mp-se/stirplate/cad/Stirplate.pdf

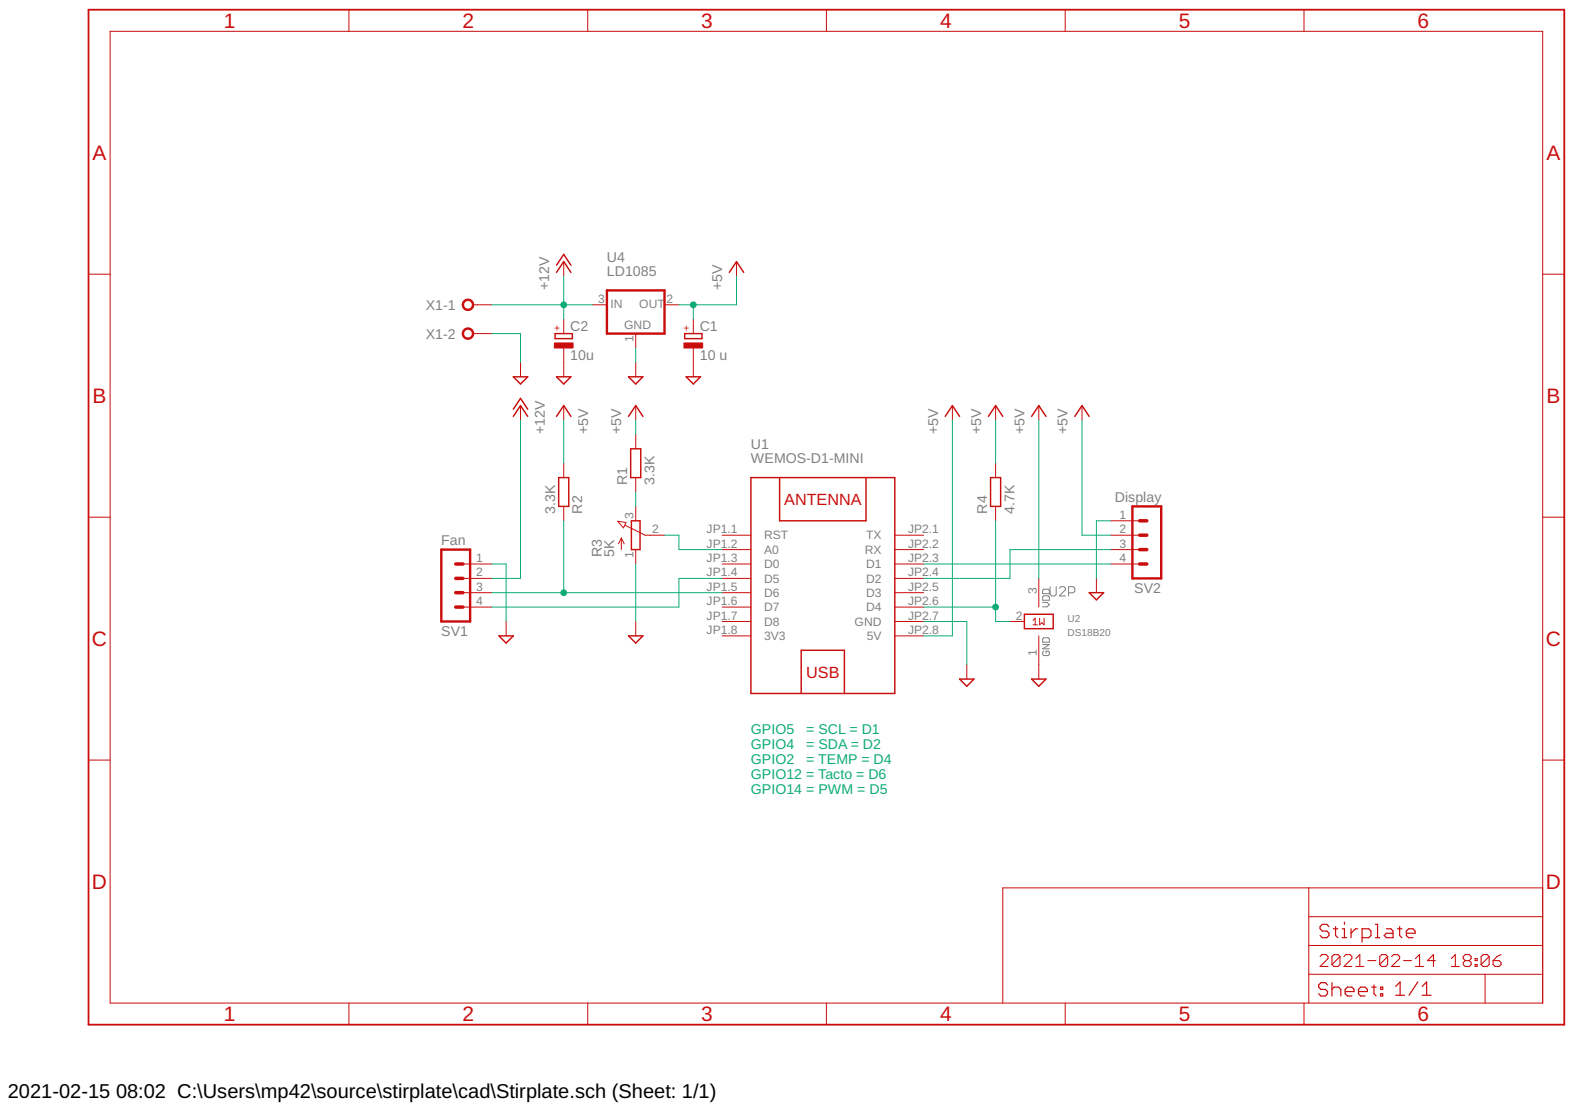
[picture p8: page 1]

JP2.5 D4
JP2.6 GND JP2.7

2021-02-15 08:02 C:\Users\mp42\source\stirplate\cad\Stirplate.sch (Sheet: 1/1)
