mp-se/stirplate/src/main.cpp

/*
MIT License

Copyright (c) 2021 Magnus

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
THE SOFTWARE IS PROVIDED "AS IS", WITHOUT WARRANTY OF ANY KIND, EXPRESS OR
IMPLIED, INCLUDING BUT NOT LIMITED TO THE WARRANTIES OF MERCHANTABILITY,
FITNESS FOR A PARTICULAR PURPOSE AND NONINFRINGEMENT. IN NO EVENT SHALL THE
AUTHORS OR COPYRIGHT HOLDERS BE LIABLE FOR ANY CLAIM, DAMAGES OR OTHER
LIABILITY, WHETHER IN AN ACTION OF CONTRACT, TORT OR OTHERWISE, ARISING FROM,
OUT OF OR IN CONNECTION WITH THE SOFTWARE OR THE USE OR OTHER DEALINGS IN THE
SOFTWARE.
 */
#include "helper.h"
#include "display.h"
#include "pwmfan.h"
#include "config.h"
#include "blynk.h"
#include "pushtarget.h"
#include "analogsensor.h"
#include "tempsensor.h"
#include "wifi.h"

// Settings for double reset
#define ESP8266_DRD_USE_RTC       true
#define DRD_TIMEOUT               1
#define DRD_ADDRESS               0
#define DOUBLERESETDETECTOR_DEBUG true
#include <ESP_DoubleResetDetector.h>            
DoubleResetDetector *drd;

/*
 * This is the fan I used for my build.
 * https://noctua.at/pub/media/wysiwyg/Noctua_PWM_specifications_white_paper.pdf
 * Blue = PWM
 * Green = RPM 
 * Yellow = 12V
 * Black = GND
 * 
 * PWM Frequency: Target frequency 25 kHz, 
 * acceptable operational range 21 kHz to 28 kHz 
 * Maximum voltage for logic low: VIL = 0.8 V 
 * Absolute maximum current sourced: Imax = 5 mA (short circuit current)  
 * Absolute maximum voltage level: VMax = 5.25 V (open circuit voltage) 
 * This signal must be pulled up to a maximum of 5.25V within the fan.
 */

// Define constats for this program
#define LOOP_INTERVAL 100                // ms, time to wait between running the loop code
const static int     tachPIN = 12;       // Measure speed on FAN. D6 PIN on ESP-12F

//
// Callback for tachimeter
// 
void ICACHE_RAM_ATTR handleTachiometerInterrupt() {
    myFan.tachCallback();
}

//
// Main setup 
//
void setup() {

    // Initialize pin outputs
    Log.notice(F("Main: Started setup for %s." CR), String( ESP.getChipId(), HEX).c_str() );
    printBuildOptions();
    drd = new DoubleResetDetector(DRD_TIMEOUT, DRD_ADDRESS);
    bool dt = drd->detectDoubleReset();  

    Log.notice(F("Main: Loading configuration." CR));
    myConfig.checkFileSystem();
    myConfig.loadFile();

    Log.notice(F("Main: Setting up devices." CR));

#if LOG_LEVEL==6
//  Log.verbose(F("MAIN: Wait 5s for debugger to come online." CR));
//  delay(5000);
#endif

    // Setup watchdog
    ESP.wdtDisable();
    ESP.wdtEnable( LOOP_INTERVAL * 2 );

    // Setup display
    Log.notice(F("Main: Looking for display." CR));
    myDisplay.init();

    char buffer[20];
    sprintf( &buffer[0], "%s", CFG_APPNAME );
    myDisplay.printText( 0, 0, &buffer[0] );    

#if defined( ACTIVATE_WIFI )
    if( dt ) 
        Log.notice(F("Main: Detected doubletap on reset." CR));

    myDisplay.printText( 0, 1, "Connect wifi    " );    
    myWifi.connect( dt );
    if( myWifi.isConnected() )
        Log.notice(F("Main: Connected to wifi ip=%s." CR), myWifi.getIPAddress().c_str() );
#endif

#if defined( ACTIVATE_WIFI ) && defined( ACTIVATE_OTA )
    myDisplay.printText( 0, 1, "Checking for upd" );    
    if( myWifi.isConnected() && myWifi.checkFirmwareVersion() ) {
        delay(500);
        myDisplay.printText( 0, 1, "Updating        " );    
        myWifi.updateFirmware();
    }
#endif

    // Setup interrput callback for tachiometer (fan rotation)
    pinMode(tachPIN, INPUT_PULLUP);
    attachInterrupt(digitalPinToInterrupt(tachPIN), handleTachiometerInterrupt, FALLING);

#if defined( ACTIVATE_BLYNK ) && defined( ACTIVATE_WIFI )
    if( myWifi.isConnected() && myConfig.isBlynkActive() ) {
        Log.notice(F("Main: Connecting to blynk." CR));
        myDisplay.printText( 0, 1, "Connect blynk   " );   
        myBlynk.connect( myConfig.getBlynkToken(), myConfig.getBlynkServer(), myConfig.getBlynkServerPort() );
    }
#endif

    Log.notice(F("Main: Setting up sensors." CR));
    myAnalogSensor.setup();
#if defined( ACTIVATE_TEMP )
    myTempSensor.setup();
#endif

#if LOG_LEVEL==6
//  Log.verbose(F("MAIN: Wait 5s." CR));
//  delay(5000);
#endif
    Log.notice(F("Main: Setup is completed." CR));
}

// Variables used in the main loop
int            loopCounter = 0;        // used in the loop 
int            loopTempCounter = 0;    // used to swap between temp and rpm 
unsigned long  loopLastMillis = 0;
int            loopLastVin = 0;        // Last value of analog pot (used to force display update) 

//
// Main loop
//
void loop() {

    // Check for double tap
    drd->loop();

#if defined( ACTIVATE_WIFI )
    // Execute the webserver stuff
    myWifi.loop();    
#endif

#if defined( ACTIVATE_BLYNK ) && defined( ACTIVATE_WIFI )
    // Execute the blynk stuff
    myBlynk.loop();
#endif

    // We dont run this in a tight loop, every 500 ms is fast
    if( abs(millis() - loopLastMillis) > LOOP_INTERVAL ) {

        // Reset the counter
        loopLastMillis = millis();

        // We vary what parts of the code is run every main loop. Some parts like display 
        // updates/temp reading can be done more seldom. 
        loopCounter++;

        // This code is run every loop.
        // -----------------------------------------------------------
        // setPower will map the value to the range supported by the PWM output
        int vin = myAnalogSensor.readSensor();
        int rpm = myFan.getCurrentRPM();
        int pwr = myFan.getCurrentPower();

        // Update the power setting based on current pot reading
        myFan.setPower( vin, 0, POT_MAX_READING );      // (value, min,  max) reading of value

        // Use the lower line to create a power bar that indicate power to stirplate
#if LOG_LEVEL==6
        //Log.verbose(F("MAIN: POT = %d, Percentage %d, RPM=%d." CR), vin, pwr, rpm);
#endif

#if defined( ACTIVATE_TEMP )
        bool tempAttached = myTempSensor.isSensorAttached();
        float tempC = myTempSensor.getValueCelcius();
        float tempF = myTempSensor.getValueFarenheight();
#endif

        // This code is run every 1 seconds or when we have an updated power setting
        // -------------------------------------------------------------------------
        if( !(loopCounter % 10) || vin!=loopLastVin ) {

#if LOG_LEVEL==6
            // Log.verbose(F("MAIN: Running 1 second loop." CR));
#endif
            loopLastVin = vin;

            // Update push targets and blynk every 2 seconds
            // -------------------------------------------------------------------------
            if( !(loopCounter % 20) ) {
#if defined( ACTIVATE_BLYNK ) && defined( ACTIVATE_WIFI )
                if( myWifi.isConnected() && myBlynk.isActive() ) {
                    myBlynk.writeRemoteRPM( rpm );
                    myBlynk.writeRemotePower( pwr );
                    myBlynk.writeRemoteVer(CFG_APPVER);
                }
    #if defined( ACTIVATE_TEMP )
                if( tempAttached ) {
                    myBlynk.writeRemoteTempC(tempC);
                    myBlynk.writeRemoteTempF(tempF);
                }
    #endif
#endif // ACTIVATE_BLYNK && ACTIVATE_WIFI
#if defined( ACTIVATE_PUSH ) && defined( ACTIVATE_WIFI )
                myPushTarget.send( rpm, myConfig.isTempC() ? tempC : tempF ); 
#endif
            }

            // Display Layout 
            //
            //  |123456789.123456| - Startup messages
            // 1|Stir plate      |
            // 2|Connect wifi    | - Step 1 
            // 2|Firmware check  | - Step 2
            // 2|Updating        | - Step 3
            // 2|Connect blynk   | - Step 4

            //  |123456789.123456| - No power on 
            // 1|Stir plate 0.0.0| - Version 
            // 2|wifi            | - wifi connected
            // 2|No wifi         | - no wifi connected

            //  |123456789.123456| - Power on
            // 1|Stir plate  0rpm| - RPM (Variera var 5:e sekund med TEMP)
            // 2|-progress-  000%| - Progress + % power

            //  |123456789.123456| - Power on
            // 1|Stir plate   20C| - Temperator (Variera var 5:e sekund med RPM) - Välja temperatur (C/F)
            // 2|-progress-  000%| - Progress + % power

            // If there is no power we show the version number, else the RPM

            char s[10];

            // If the stirplate is not running we show the version number
            if( myFan.getCurrentPower() < 10 ) { 
                sprintf( &s[0], "%5s", CFG_APPVER);

#if defined( ACTIVATE_WIFI )      
                if( myWifi.isConnected() )
                    myDisplay.printText( 0, 1, "WIFI            " );
                else
                    myDisplay.printText( 0, 1, "NO WIFI         " );
#else 
                myDisplay.printText( 0, 1, "                " );
#endif // ACTIVATE_WIFI
            } else {
                // Create progress bar
                myDisplay.printProgressBar(0,1, pwr);

                // Show RPM
                sprintf( &s[0], "%5d", myFan.getCurrentRPM());

                // Show Temp
#if defined( ACTIVATE_TEMP )
                if( loopTempCounter++ > 10 )
                    loopTempCounter = 0;

                // Every 5 seconds we swap between RPM and TEMP if there is a temp sensor attached
                if( loopTempCounter>5 && tempAttached ) {
                    if( myConfig.isTempC() )
                        sprintf( &s[0], "%3d C", (int) tempC);      
                    else
                        sprintf( &s[0], "%3d F", (int) tempF);      
                }
#endif
            }

            myDisplay.printText( 11, 0, &s[0] );
        }

        // This code is run every 5 seconds.
        // -----------------------------------------------------------
        if( !(loopCounter % 50) ) {
#if LOG_LEVEL==6
            //Log.verbose(F("MAIN: Running 2,5 second loop." CR));
#endif
            // Used to calculate the RPM value. 
            myFan.loop();
        }

        // This code is run every 10 seconds.
        // -----------------------------------------------------------
        if( !(loopCounter % 100) ) {
            // Since the tempsensor can be remove/added we check if there is a change 
#if defined( ACTIVATE_TEMP )
            myTempSensor.setup();
#endif
        }
    }
}

// EOF
