mp-se/stirplate/src/analogsensor.cpp

/*
MIT License

Copyright (c) 2021 Magnus

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
THE SOFTWARE IS PROVIDED "AS IS", WITHOUT WARRANTY OF ANY KIND, EXPRESS OR
IMPLIED, INCLUDING BUT NOT LIMITED TO THE WARRANTIES OF MERCHANTABILITY,
FITNESS FOR A PARTICULAR PURPOSE AND NONINFRINGEMENT. IN NO EVENT SHALL THE
AUTHORS OR COPYRIGHT HOLDERS BE LIABLE FOR ANY CLAIM, DAMAGES OR OTHER
LIABILITY, WHETHER IN AN ACTION OF CONTRACT, TORT OR OTHERWISE, ARISING FROM,
OUT OF OR IN CONNECTION WITH THE SOFTWARE OR THE USE OR OTHER DEALINGS IN THE
SOFTWARE.
 */
#include "analogsensor.h"
#include "helper.h"

#if defined( ACTIVATE_BLYNK ) && defined( ACTIVATE_WIFI )
#include "blynk.h"
#endif

AnalogSensor myAnalogSensor;

//
// Setup analog input
//
void AnalogSensor::setup() {
#if LOG_LEVEL==6
//    Log.verbose(F("ASEN: Setting up analog sensor." CR));
#endif
    pinMode(analogPIN, INPUT);    
#ifdef SIMULATE_SENSOR
    simualteMillsStart = millis();
#endif
}

//
// Set the speed of the pwmsignal
//
int AnalogSensor::readSensor() {
#if LOG_LEVEL==6
//    Log.verbose(F("ASEN: Reading analog sensor." CR));
#endif

#ifdef SIMULATE_SENSOR
    value = simulateSensor();
    return value;
#endif

#if defined( ACTIVATE_BLYNK ) && defined( ACTIVATE_WIFI )
    if( myBlynk.readRemoteToggle() == 1 ) {
        value = map( myBlynk.readRemotePower(), 0, 100, 0, 1024);

        //Log.verbose(F("ASEN: Remote power enabled, using %d." CR), value);
        return value;
    }
#endif

    //
    // This code will read the power value from the potentiometer and map that towards a PWN signal for the fan + 
    // write the current level to the display
    //
    // Input will vary between 0-1024 and output should be limited to 0-255 according to documentation.
    //
    value = analogRead(analogPIN); 
    return value;
}

#ifdef SIMULATE_SENSOR

// Format, timestamp(s)-value
struct SimPoint { 
    unsigned long time;
    int power;
};

const SimPoint simSequenceSensor[] = {
    {   0,    0 },
    {  15,  200 },
    {  20,  300 },
    {  25,  400 },
    {  30,  500 },
    {  45,  600 },
    {  50,  700 },
    {  60,  800 },
    {  70,  900 },
    {  80, 1000 },
};

//
// Used to simualte sensor value if no analog input is avaialble.
//
int AnalogSensor::simulateSensor() {
    unsigned long tstamp = abs( millis() - simualteMillsStart ) / 1000;
    int max = (sizeof(simSequenceSensor) / sizeof(SimPoint));
    int v = simSequenceSensor[max-1].power;

    for(int i = 0; i < max; i++ ) {
        if( simSequenceSensor[i].time <= tstamp )
            v = simSequenceSensor[i].power;
    }

#if LOG_LEVEL==6
//  Log.verbose(F("ASEN: Value simulator %l, value %d." CR), tstamp, v);
#endif
    return v;
}

#endif // SIMULATE_SENSOR

// EOF 
