mp-se/stirplate/src/blynk.cpp

/*
MIT License

Copyright (c) 2021 Magnus

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
THE SOFTWARE IS PROVIDED "AS IS", WITHOUT WARRANTY OF ANY KIND, EXPRESS OR
IMPLIED, INCLUDING BUT NOT LIMITED TO THE WARRANTIES OF MERCHANTABILITY,
FITNESS FOR A PARTICULAR PURPOSE AND NONINFRINGEMENT. IN NO EVENT SHALL THE
AUTHORS OR COPYRIGHT HOLDERS BE LIABLE FOR ANY CLAIM, DAMAGES OR OTHER
LIABILITY, WHETHER IN AN ACTION OF CONTRACT, TORT OR OTHERWISE, ARISING FROM,
OUT OF OR IN CONNECTION WITH THE SOFTWARE OR THE USE OR OTHER DEALINGS IN THE
SOFTWARE.
 */
#include "blynk.h"
#include "helper.h"

#if defined( ACTIVATE_BLYNK ) && defined( ACTIVATE_WIFI )

#if LOG_LEVEL==6
#define BLYNK_PRINT Serial
#endif

#include <ESP8266WiFi.h>
#include <BlynkSimpleEsp8266.h>

BlynkPins myBlynk;

//
// These are callback functions for updates from the Mobile App. This is the power callback (0-100%).
//
BLYNK_WRITE(V3)
{
    int v = param.asInt(); // assigning incoming value from pin V1 to a variable
#if LOG_LEVEL==6
    Log.verbose(F("BLYN: Callback V3 %d." CR), v);
#endif
    myBlynk.setRemotePower( v );
}

//
// These are callback functions for updates from the Mobile App. This is the remote activate toggle (0/1).
//
BLYNK_WRITE(V2)
{
    int v = param.asInt(); // assigning incoming value from pin V1 to a variable
#if LOG_LEVEL==6
    Log.verbose(F("BLYN: Callback V2 %d." CR), v);
#endif
    myBlynk.setRemoteToggle( v );
}

//
// Send the RPM value to the blynk server on pin V0
//
void BlynkPins::writeRemoteRPM(int v) {
    if(isActive())
        Blynk.virtualWrite(V0, v);
}

//
// Send the power value (0-100%) to the blynk server on pin V1
//
void BlynkPins::writeRemotePower(int v) {
    if(isActive())
        Blynk.virtualWrite(V1, v);
}

//
// Inform blynk about what version we are running
//
void BlynkPins::writeRemoteVer(const char *ver) {
    if(isActive())
        Blynk.virtualWrite(V4, ver);
}

//
// Write temp sensor value in C
//
void BlynkPins::writeRemoteTempC(float t) {
    if(isActive())
        Blynk.virtualWrite(V5, t);
}

//
// Write temp sensor value in F
//
void BlynkPins::writeRemoteTempF(float t) {
    if(isActive())
        Blynk.virtualWrite(V6, t);
}

//
// Connect to the WIFI and blynk server
//
void BlynkPins::connect(const char* blynkToken, const char *ip, int port) {

    if( strlen(blynkToken)>0 ) {
        IPAddress bs(0,0,0,0);
        bs.fromString(ip);
    #if LOG_LEVEL==6
        Log.verbose(F("BLYN: connect %s." CR), bs.toString().c_str());
    #endif    
        if( strlen(ip) > 0)
            Blynk.config(blynkToken, bs, (uint16_t) port);
        else
            Blynk.config(blynkToken);
        Blynk.syncAll();
        Blynk.run();
        active = true;
    }
}

//
// Call the run method in the blynk library (should be called in the loop)
//
void BlynkPins::loop() {
    // Dont put serial debug output in this call
    if(isActive())
        Blynk.run();
}

#endif // ACTIVATE_BLYNK && ACTIVATE_WIFI 

// EOF 
