mp-se/stirplate/(commit log)

2021-01-26 First release
    [schema.kicad_pcb, schema.sch]
2021-01-31 Updated doc + prepare for temp sensor
2021-02-02 Missed clearing one char on text output
    [main.cpp]
2021-02-02 Updated temp sensor code and blynk
2021-02-04 Draft PCB with Eagle
    [Stirplate.brd, Stirplate.sch, schema.kicad_pcb, schema.sch]
2021-02-14 Version for testing temperature support
2021-02-24 Testing v1.5.1
    [Stirplate.brd]
2021-02-25 Added id check to reset/wifi calls
    [wifi.cpp]
